JOSHUA5227/Hardware-Accelerated-2048-VGA-Game/docs/images/TTO_2048_HVSync.png

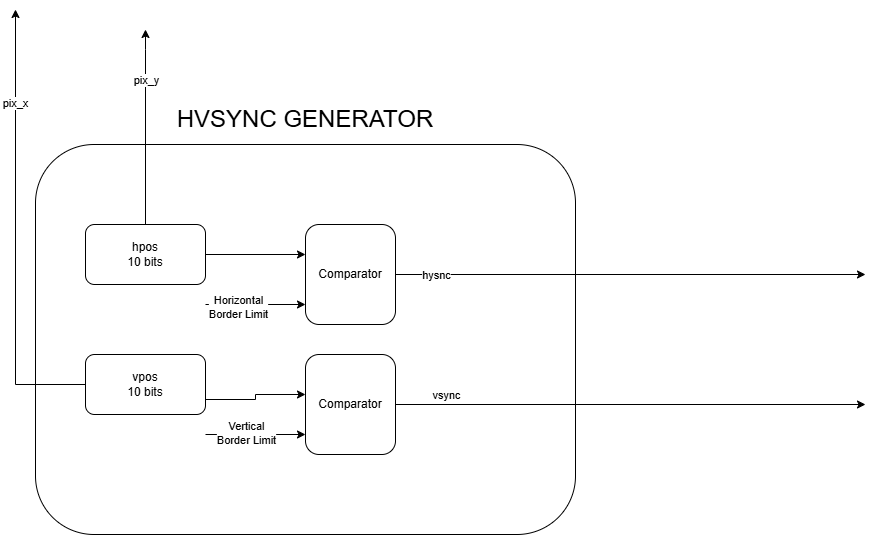
docs/images/TTO_2048_HVSync.png
