JOSHUA5227/Hardware-Accelerated-2048-VGA-Game/(commit log)

2026-10-28 update logic insertion
2026-10-28 improved button logic
2026-10-29 1. Made changes in S3 change incase someone pressed any other button while we release our initially pressed button. 2.Connected the registered select line to the Demux
2026-11-02 final game size: 256x256 board
2026-11-03 randomizer and vga_controller added wire; reset_sync added and intrgrated in project.v
    [project.v, randomizer.v, reset_sync.v, vga_controller.v]
2026-11-12 accounted for reset sync deassertion delay
    [test.py]
2026-11-12 Revert "accounted for reset sync deassertion delay"
    This reverts commit 6653f4386de9df91d08b9dbc281122948aba9e89.
    [test.py]
